Abse2001/GameBoy/gba-rp2350/experiments/fabrication/imports/A_0402WGF1002TCE/A_0402WGF1002TCE.step

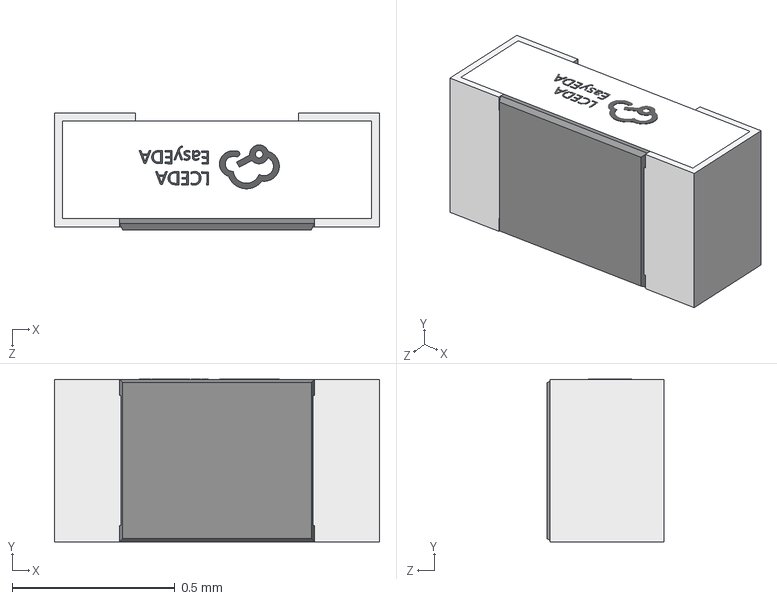
[picture p1: CAD file, 2026-09-06]
gba-rp2350/experiments/fabrication/imports/A_0402WGF1002TCE/A_0402WGF1002TCE.step
1.00 x 0.501 x 0.36 mm
