Abse2001/GameBoy/gba-rp2350/experiments/fabrication/imports/AP2112K_3_3TRG1/AP2112K_3_3TRG1.step

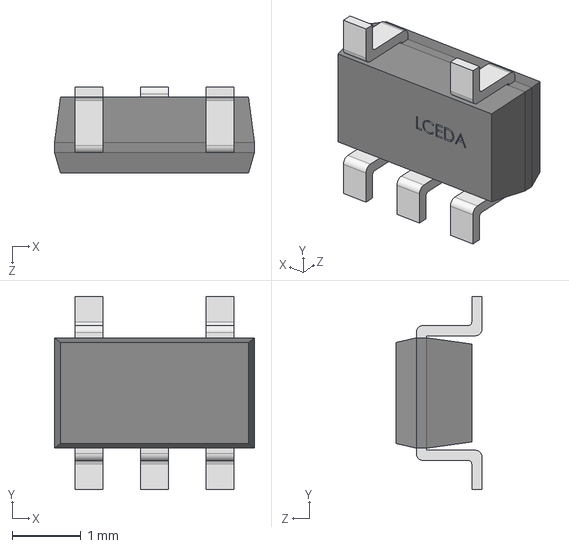
[picture p2: CAD file, 2026-09-07]
gba-rp2350/experiments/fabrication/imports/AP2112K_3_3TRG1/AP2112K_3_3TRG1.step
2.90 x 2.80 x 1.25 mm
