Abse2001/GameBoy/gba-rp2350/experiments/fabrication/imports/APS6404L_3SQR_SN/APS6404L_3SQR_SN.step

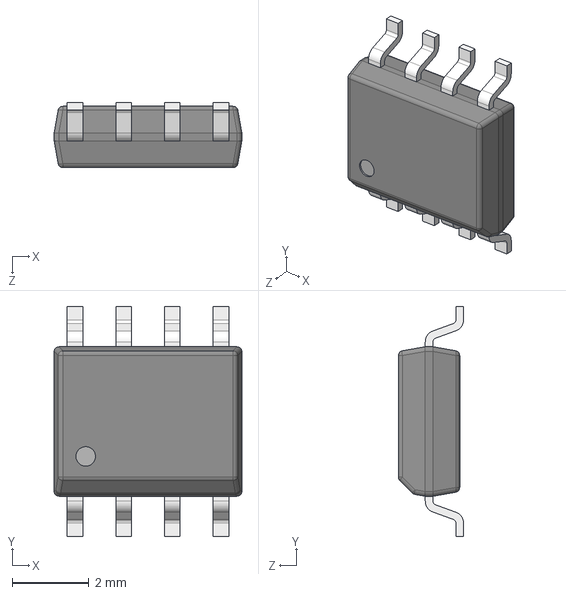
[picture p3: CAD file, 2026-09-06]
gba-rp2350/experiments/fabrication/imports/APS6404L_3SQR_SN/APS6404L_3SQR_SN.step
4.90 x 6.00 x 1.70 mm
