Abse2001/GameBoy/gba-rp2350/experiments/fabrication/imports/CL05B104KO5NNNC/CL05B104KO5NNNC.step

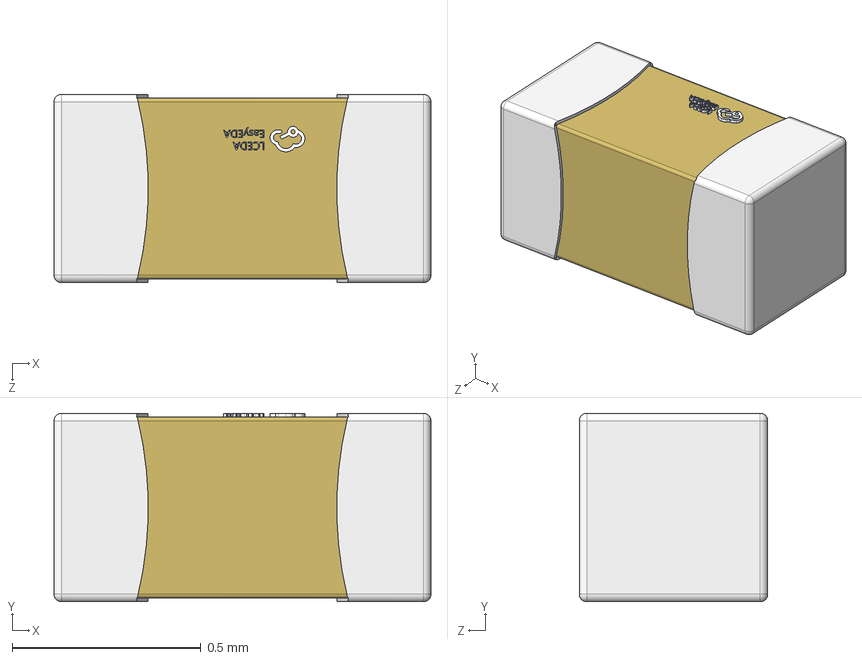
[picture p4: CAD file, 2026-09-06]
gba-rp2350/experiments/fabrication/imports/CL05B104KO5NNNC/CL05B104KO5NNNC.step
1.00 x 0.5 x 0.5 mm
