Abse2001/GameBoy/gba-rp2350/experiments/fabrication/imports/CL10A105KB8NNNC/CL10A105KB8NNNC.step

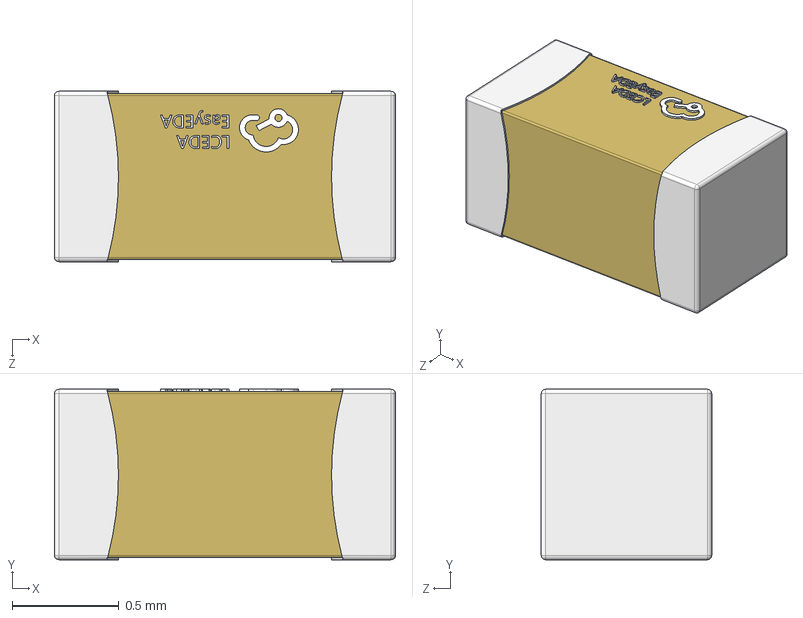
[picture p5: CAD file, 2026-09-06]
gba-rp2350/experiments/fabrication/imports/CL10A105KB8NNNC/CL10A105KB8NNNC.step
1.60 x 0.8 x 0.8 mm
