Abse2001/GameBoy/gba-rp2350/experiments/fabrication/imports/SKRTLAE010/SKRTLAE010.step

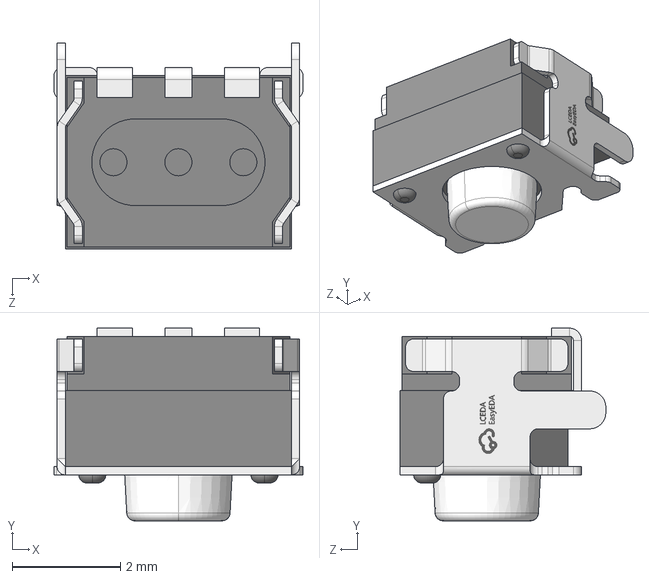
[picture p6: CAD file, 2026-09-07]
gba-rp2350/experiments/fabrication/imports/SKRTLAE010/SKRTLAE010.step
4.60 x 3.56 x 3.80 mm
