Abse2001/GameBoy/gba-rp2350/experiments/fabrication/imports/SRV05_4_P_T7/SRV05_4_P_T7.step

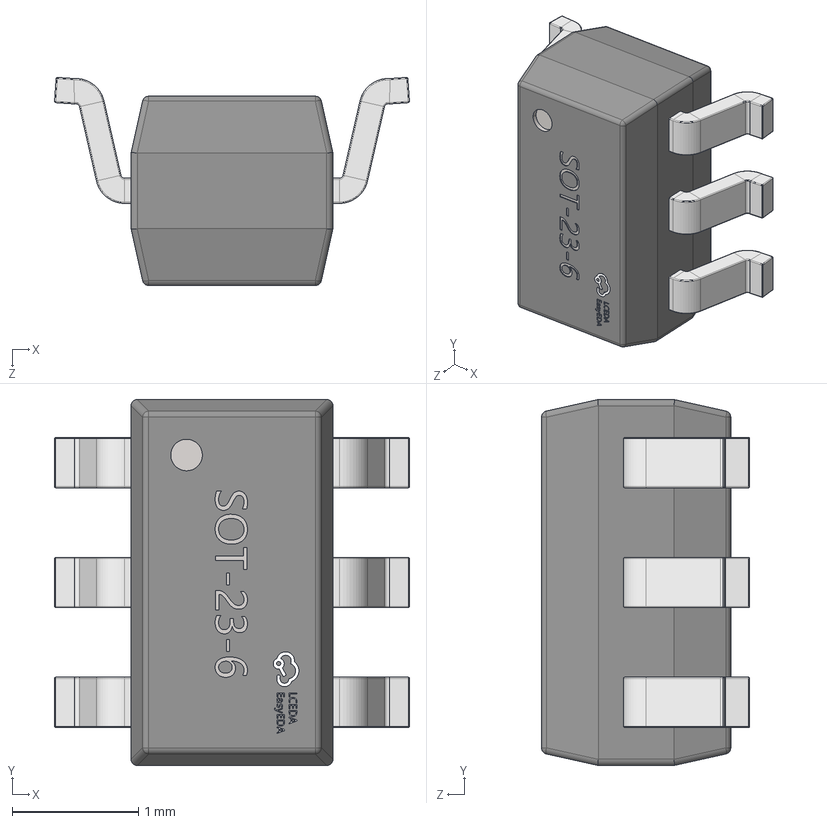
[picture p7: CAD file, 2026-09-06]
gba-rp2350/experiments/fabrication/imports/SRV05_4_P_T7/SRV05_4_P_T7.step
2.81 x 2.90 x 1.65 mm
