Abse2001/GameBoy/gba-rp2350/experiments/fabrication/imports/TF_01A/TF_01A.step

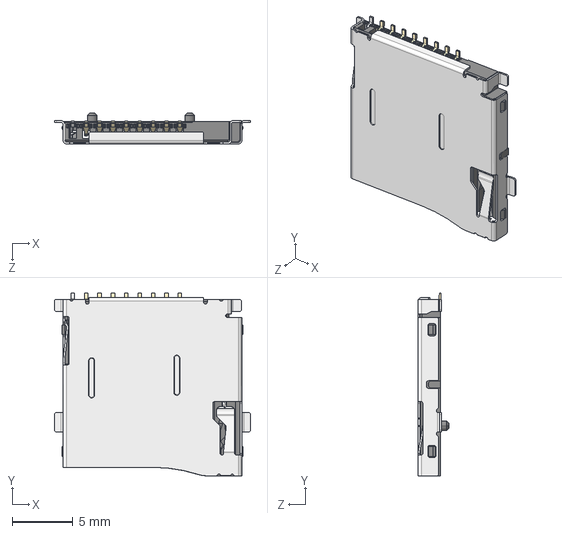
[picture p8: CAD file, 2026-09-06]
gba-rp2350/experiments/fabrication/imports/TF_01A/TF_01A.step
16.1 x 15.0 x 2.55 mm
