Abse2001/GameBoy/(list of files, cad)

Other CAD files:
gba-rp2350/experiments/fabrication/imports/AP2112K_3_3TRG1/AP2112K_3_3TRG1.obj
gba-rp2350/experiments/fabrication/imports/APS6404L_3SQR_SN/APS6404L_3SQR_SN.obj
gba-rp2350/experiments/fabrication/imports/A_0402WGF1002TCE/A_0402WGF1002TCE.obj
gba-rp2350/experiments/fabrication/imports/CL05B104KO5NNNC/CL05B104KO5NNNC.obj
gba-rp2350/experiments/fabrication/imports/CL10A105KB8NNNC/CL10A105KB8NNNC.obj
gba-rp2350/experiments/fabrication/imports/CL10A106KP8NNNC/CL10A106KP8NNNC.obj
gba-rp2350/experiments/fabrication/imports/SKRTLAE010/SKRTLAE010.obj
gba-rp2350/experiments/fabrication/imports/SRV05_4_P_T7/SRV05_4_P_T7.obj
gba-rp2350/experiments/fabrication/imports/TF_01A/TF_01A.obj
