Abse2001/GameBoy/(commit log)

2026-06-25 fix button bug
2026-07-03 fix traces min width
2026-09-06 Compare full RP2350 Game Boy placements and supply pours in CI
    [APS6404L_3SQR_SN.obj, APS6404L_3SQR_SN.step, A_0402WGF1002TCE.obj, A_0402WGF1002TCE.step, CL05B104KO5NNNC.obj, CL05B104KO5NNNC.step, CL10A105KB8NNNC.obj, CL10A105KB8NNNC.step]
2026-09-06 Narrow imported CAD paths before validating files
2026-09-06 Correct capacitor clearance and compare USB resistor placement
2026-09-06 Compare MCU memory and supply-capacitor spacing in remote CI
2026-09-06 Compare clock and card-detect resistor placement in CI
2026-09-07 Move SWD escapes out of shared SPI corridor
2026-09-07 fit GBA board to clean housing envelope
2026-09-07 Compare GBA power-plane coverage and global routing
2026-09-07 Align MCU copper islands and reserve ground reference plane
2026-09-07 Keep top ground fill outside membrane contact fields
2026-09-07 Shorten USB escapes and open the crystal resistor routing corridor
2026-09-07 Select genuine Diodes LDO and record assembly-stock blockers
    [AP2112K_3_3TRG1.obj, AP2112K_3_3TRG1.step]
2026-09-07 Restore routable MCU resistor placement and tighten LDO decoupling
2026-09-07 Enforce board-wide routing with ordinary functional groups
2026-09-07 Test shorter GBA regulator input-capacitor placement
2026-09-07 Test inward automatic PGND escape clear of regulator keepout
2026-09-07 Run current no-subcircuit Pipeline 7 GBA candidate in CI
    [SKRTLAE010.obj, SKRTLAE010.step]
